tomverbeure/aha363/pcb/stripped-back.jpg

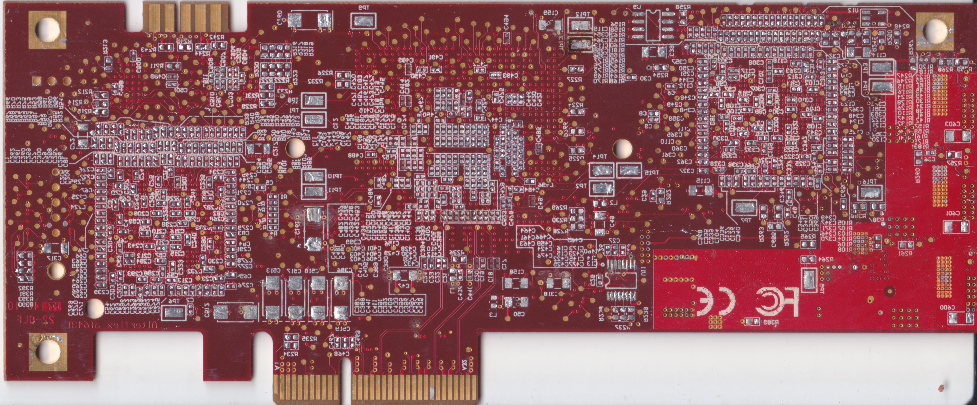
pcb/stripped-back.jpg
