tomverbeure/aha363/pcb/stripped-front.jpg

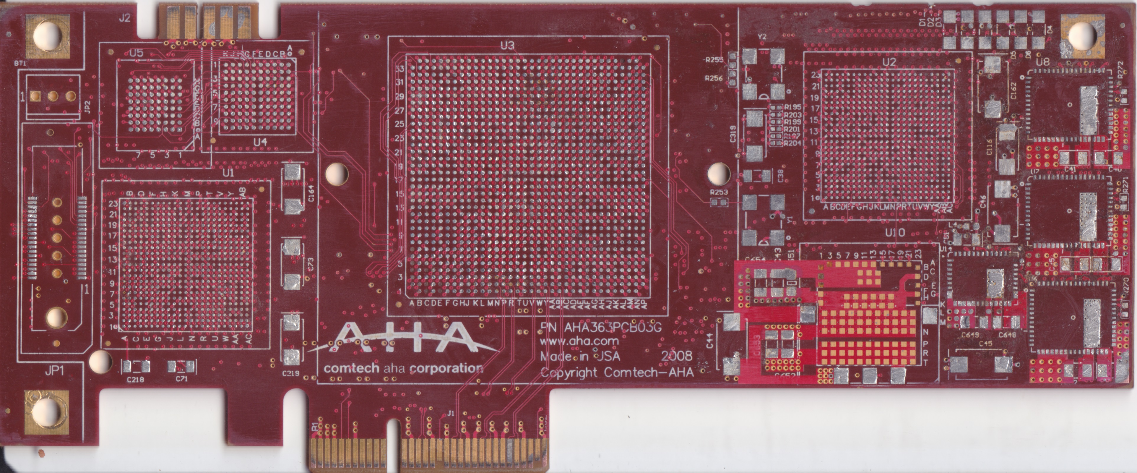
pcb/stripped-front.jpg
