tomverbeure/aha363/(list of files, cad)

Other CAD files:
quartus/stp1.stp
