tomverbeure/aha363/pcb/kicad/aha-kicad.sch

## KiCad design pcb/kicad/aha-kicad.sch (2020-07-03)

Schematic: aha-kicad.sch

Parts:
C17, C18, C19, C20, C21, C22, C23, C24, C26, C27, C28, C29, C38, C39, C363, C486, C487, C489, C490, C491, C492, C493, C494, C496: C
C498: C; C_0402_1005Metric
D1, D2, D3, D4, D5, D6: LED
J2: Conn_02x05_Counter_Clockwise; jtag
JP2: Conn_01x03_Male; FanPinHeader_1x03_P2.54mm_Vertical
R212, R213, R214, R215, R242, R243, R244, R245, R257, R259, R267, R268, R272: R; R_0603_1608Metric
R227, R234, R235, R236, R237, R238, R241, R249, R250, R252, R253, R254, R255, R256, R258: R
R_IDK_1, R_IDK_2: R
U1, U2: AHA3610B
U3: EP1AGX90E
U4: EPM570F100; BGA-100_11.0x11.0mm_Layout10x10_P1.0mm_Ball0.5mm_Pad0.4mm_N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
U5: S29GL128P; flash
U6, U7, U8: EN5365QI
U9: LP2996A
U11: LM83
Y1, Y2: ASCO; Oscillator_SMD_Abracon_ASCO-4Pin_1.6x1.2mm
u12: Q_NPN_BCE

Notes on the sheet:
TRANSISTOR GUESSED
