tomverbeure/aha363/(commit log)

2019-11-07 Saleae power-up trace
2019-11-07 Minimal quartus setup
    [stp1.stp]
2019-11-07 Boundary scan traces.
2020-06-29 Add scans of stripped PCB
2020-06-29 Add minimal schematic
    [aha-kicad.sch]
2020-06-29 Add PCIE connector to schematic, update README with some new pin info
    [aha-kicad.sch]
2020-07-03 Correct some power connections, a couple other bits and bobs
    [aha-kicad.sch]
2020-07-03 Add PCB images I thought I committed already
2020-07-03 Correct image filename case
